fmonpelat/66.09_Laboratorio_de_Microcomputadoras-TP/README.md

# 66.09_Laboratorio_de_Microcomputadoras-TP
El proyecto consiste en un sistema electrónico diseñado para ser instalado en cualquier paquete o vehículo, capaz de loguear distintas informaciones de rastreabilidad, trayectoria en su recorrido y almacenar dicha información (histórico) en una memoria.
El dispositivo guardará en tiempos determinados (previamente configurados por el usuario), la ubicación y la orientación además de su velocidad.
El usuario podrá luego extraer su memoria para visualizar los datos en una computadora.
